HXRSHGIT/Smart-Watch-Rev-1.1/README.md

# Smart Watch Rev 1.1 — HealthOS Band R&D

R&D repository for the client's **HealthOS Band** (WHOOP-style wellness band with a hidden 64×32 OLED).
Source brief: [`docs/HARDWARE_ENGINEER_HANDOFF_REQUIREMENTS.md`](docs/HARDWARE_ENGINEER_HANDOFF_REQUIREMENTS.md) (copied unchanged).

Done by Harsh Thakur.

## Current decision - Iteration 1

**Approved 2026-10-18:** build a USB-powered custom sensor-test PCB using **ESP32-C3-MINI-1-N4 + MAX30102 + MAX30208**. A board larger than the final band is acceptable. Use USB for raw-data logging and test BLE; the module's 4 MB flash is sufficient for firmware/settings and limited logs, so **no external flash is fitted**.

The authoritative scope, selected parts, power/interface circuits, deferred features and bring-up gates are in **[Iteration 1 decision](docs/ITERATION_1_DECISION.md)**. Temperature sensing is included; battery charging, display, haptics, motion/pressure sensors and NFC are deferred. This freezes the iteration's direction, not a fabrication-ready or sourcing-verified BOM.

For the next engineering stage, see **[Iteration 1 schematic connection plan](docs/ITERATION_1_SCHEMATIC_FLOW.md)**: power and signal flow, proposed GPIO map, sensor interfaces, USB/boot/debug wiring and the checks required before schematic/layout release.

The client-facing **[Component Selection](docs/COMPONENT_SELECTION.md)** explains every selected part, its purpose, implementation considerations and the features deferred from the first board.

The documents under `research/` describe the earlier full-wearable investigations. Their parts and performance estimates are **not the current Iteration 1 BOM**. The original client brief remains intact as the longer-term product reference.

## How this repo is organised

`main` holds the brief, this index, the R&D map **and all research merged in** (folders below). Each topic also stays on its **own `rnd/*` branch** for a separate view.

| Branch | Folder | Covers (brief §) |
|---|---|---|
| `rnd/components` | [`research/components/`](research/components/) | §8 — every candidate part plus alternatives, full detail (`COMPONENTS.md`) |
| `rnd/mcu-ble` | [`research/mcu-ble/`](research/mcu-ble/) | §4.6, §8 — nRF5340 vs nRF54, BLE security, DFU, antenna |
| `rnd/storage-nfc-dft` | [`research/storage-nfc-dft/`](research/storage-nfc-dft/) | §4.6, §8 — external flash, active NFC, SWD, production test |
| `rnd/power-battery` | [`research/power-battery/`](research/power-battery/) | §4.7, §8 — power tree, battery sizing, battery-life model, pogo charging, peaks |
| `rnd/display-haptics` | [`research/display-haptics/`](research/display-haptics/) | §4.4, §4.5 — OLED module, dead-front, back-power, LRA and driver |
| `rnd/optical-ppg` | [`research/optical-ppg/`](research/optical-ppg/) | §4.1, §8 — PPG HR, SpO2, optical stack, crosstalk |
| `rnd/sensors` | [`research/sensors/`](research/sensors/) | §4.1 — IMU, pressure and vent, skin temperature, time sync |
| `rnd/algorithms` | [`research/algorithms/`](research/algorithms/) | §4.2, §4.3, §5 — activity, calories, sleep, HRV and other P1 algorithms |
| `rnd/validation` | [`research/validation/`](research/validation/) | §13–15 — test plan, compliance, mechanical, RF, water and sweat |

## Earlier wearable R&D findings (historical, not the Iteration 1 baseline)

These findings are retained as research history, including assumptions and claims requiring further verification. In particular, the original PPG pulse limits, PVLED headroom reasoning, BMI270 current, NFC power assumptions and battery estimates must be rechecked before reuse. See the current decision above for what will actually be fitted now.

1. **Battery life is a PPG-settings decision.** Same hardware: ≈ 5 / 10 / 29 mAh per day for lean / typical / continuous-100-sps profiles → 5 days needs ≈ 32 / 61 / 184 mAh. Suggested target: 5 days on ≈ 150 mAh with adaptive PPG (`rnd/power-battery`).
2. **SoC: nRF54L15** (CSP if HDI is available) instead of nRF5340 — saves ≈ 50 mm²; battery difference ≈ 2 µA (`rnd/mcu-ble`).
3. **One 1.8 V digital rail.** MAX86141 is 1.8 V SPI, so swap the 3 V-only W25Q32RV flash for Macronix MX25R3235F (`rnd/storage-nfc-dft`).
4. **PPG LED supply needs ≥ 3.1 V** and cannot come from the nPM1300 bucks — VBAT direct (HR pauses near empty) or a small boost (`rnd/power-battery`, `rnd/optical-ppg`).
5. **Drop the active NFC reader** (no use case, ≈ 400 mA peak); the SoC's passive NFC tag gives tap-to-pair for free (`rnd/storage-nfc-dft`).
6. **BMI270 always-on accel (≈ 210 µA, verify) is a top load**, and it cannot do wrist-raise and tap at the same time — consider a low-power wake accelerometer (`rnd/sensors`, `rnd/display-haptics`).
7. **Stealth dead-front is not readable in direct sun**; an AR coating is the biggest improvement (`rnd/display-haptics`).
8. **SpO2 skin-tone bias is documented** — validate per Monk skin-tone group + ITA following FDA's 2025 draft study design (`rnd/optical-ppg`).
9. **Calories are the weakest output industry-wide** (27–93 % median error in published tests) — label as estimates (`rnd/algorithms`).
10. **§13 gates → 25 concrete tests**; wellness position depends on claims; water target at least IPX7 (`rnd/validation`).

## Longer-term wearable R&D map

Legend: **R&D** = open question, needs study or experiment · **Design** = known engineering, needs careful execution · **Owner** = client decision, not engineering.

| § | Point | Class | Why |
|---|---|---|---|
| 2 | Stealth dead-front vs visible OLED, same PCB | **R&D** | Transmission vs off-state blackness trade; needs material samples and measurement |
| 3 | Present all health outputs as estimates | Owner | Wording and claims policy; the sentence is cut off in the brief |
| 4.1 | Continuous / resting HR | **R&D** | Wrist PPG motion artifact; LED current vs battery |
| 4.1 | Workout HR and zones | **R&D** | HR accuracy during motion is the hardest PPG problem |
| 4.1 | Spot + sleep SpO2 | **R&D** | Reflective wrist SpO2 needs red/IR calibration against a reference; skin-tone bias |
| 4.1 | Skin temperature trend | **R&D** | Thermal isolation from PCB and battery heat; trend vs absolute |
| 4.1 | Motion data | Design | BMI270 is mature; orientation and FIFO setup |
| 4.1 | Pressure for floors | **R&D** | Waterproof breathable vent; sensitivity to wrist movement and temperature |
| 4.1 | Raw data access | Design | Logging and streaming bandwidth over BLE and flash |
| 4.1 | Sensor time sync | **R&D** | Common timebase across AFE, IMU and MCU FIFOs |
| 4.2 | Steps / distance / active min | Design | Known algorithms; tuning for wrist placement |
| 4.2 | Calories | **R&D** | Model choice (HR + motion + profile); estimate only |
| 4.2 | Floors / elevation | **R&D** | Barometer + IMU fusion |
| 4.2 | Activity classification + confidence | **R&D** | Needs a labelled dataset and an on-device model budget |
| 4.3 | Sleep detection / duration | **R&D** | Actigraphy + HR; validation vs reference |
| 4.3 | HW readiness for HRV / RR / stages | **R&D** | Sets PPG sample rate and timing jitter requirements now |
| 4.4 | 64×32 OLED module choice | **R&D** | Exact orderable module, flex, cover stack, outdoor readability |
| 4.4 | No back-power when display off | Design | Load switch + I/O state; measure leakage |
| 4.4 | Wake by gesture / tap | **R&D** | False-wake rate vs IMU power |
| 4.5 | LRA selection + patterns | **R&D** | Size, resonance, peak current, mounting in a thin band |
| 4.6 | BLE Android/iOS | Owner | Platforms to support |
| 4.6 | Secure pairing + authenticated DFU | Design | MCUboot / nRF Connect SDK; key management |
| 4.6 | External flash logging | Design | Capacity sizing vs offline days |
| 4.6 | SWD + production test access | Design | Pad plan, fixture |
| 4.7 | Battery capacity vs 5–7 days | **R&D** | Needs a duty-cycle power model, then a cell that fits the enclosure |
| 4.7 | Reversible pogo, faults | **R&D** | Bridge vs ideal-diode orientation fix, contact heating, ESD |
| 4.7 | Concurrent peak load | **R&D** | PPG pulses + radio + flash + haptic + NFC on a small cell |
| 4.7 | Charging limits | Design | Follow the cell datasheet; NTC wiring to nPM1300 |
| 5 | P1: HRV, RR, recovery, GPS, falls | **R&D** | Algorithm work; HW must not block it |
| 8 | MCU choice (nRF5340 vs nRF54) | **R&D** | Trade study before schematic freeze |
| 8 | Active NFC (ST25R210) | **R&D** | Use case unknown; power and antenna cost |
| 8 | Separate optical / NFC / display rails | **R&D** | Depends on the power model |
| 13 | Acceptance gates | Design | Test plan and fixtures per gate |

## Gaps in the brief

- Sections **6, 7, 9, 10, 11 and 12 are missing** (numbering jumps 5 → 8 → 13). Probably owner decisions, targets and deliverables. Ask the client.
- §3 is cut off mid-sentence: "…must be presented as estimates until the complete product".
- Open owner decisions: phone platforms, battery-life target, NFC use case, display module, water-resistance target.
