HXRSHGIT/Smart-Watch-Rev-1.1/hardware/schematic/BOM.csv

Reference | Value | Footprint | Spec | MPN | Source | Note
AE1 | 2450AT18A0100001E | smartwatch:Johanson_2450AT18A0100001E_1206 |  |  | Johanson DS 36S0021A rev 4.0
C1 | 2.2uF | Capacitor_SMD:C_0201_0603Metric | X6T 20% 2.5V |  | nRF54L15 DS v1.0 Table 87 / Fig 180
C2 | 2.2uF | Capacitor_SMD:C_0201_0603Metric | X6T 20% 2.5V |  | nRF54L15 DS v1.0 Table 87 / Fig 180
C3 | 10uF | Capacitor_SMD:C_0402_1005Metric | X6S 20% 6.3V |  | nRF54L15 DS v1.0 Table 87 / Fig 180
C4 | 100nF | Capacitor_SMD:C_0201_0603Metric | X7R 10% |  | nRF54L15 DS v1.0 Table 87 / Fig 180
C5 | 2.2nF | Capacitor_SMD:C_0201_0603Metric | X7R 10% 10V |  | nRF54L15 DS v1.0 Table 87 / Fig 180
C6 | 1.5pF | Capacitor_SMD:C_0201_0603Metric | NP0 0.05 pF 25V high Q | GJM0335C1E1R5WB01 | nRF54L15 DS v1.0 Fig 180 / Table 87
C7 | 100nF | Capacitor_SMD:C_0201_0603Metric | X7R 10% |  | nRF54L15 DS v1.0 Table 87 / Fig 180
C8 | 100nF | Capacitor_SMD:C_0201_0603Metric | X7R 10% |  | nRF54L15 DS v1.0 Table 87 / Fig 180
C9 | 2.0pF | Capacitor_SMD:C_0201_0603Metric | NP0 0.05 pF 25V | GJM0335C1E2R0WB01 | nRF54L15 DS v1.0 Fig 180 / Table 87
C10 | 100nF | Capacitor_SMD:C_0201_0603Metric | X7R 10% |  | nRF54L15 DS v1.0 Table 87 / Fig 180
C11 | 0.3pF | Capacitor_SMD:C_0201_0603Metric | C0G 0.1 pF 50V |  | nRF54L15 DS v1.0 Fig 180 / Table 87
C12 | 10nF | Capacitor_SMD:C_0201_0603Metric | X7R 6.3V |  | nRF54L15 DS v1.0 Table 87 / Fig 180
C13 | 3.9pF | Capacitor_SMD:C_0201_0603Metric | C0G 0.25pF 50V |  | nRF54L15 DS v1.0 Table 87 / Fig 180
C14 | TBD | Capacitor_SMD:C_0402_1005Metric | shunt slot, tune on worn band |  | Johanson DS 36S0021A note 4 | DNP
C15 | 22uF | Capacitor_SMD:C_0402_1005Metric | 6.3V or higher, effective ~10 uF |  | MAX86141 DS Rev 5 p.49
C16 | 100nF | Capacitor_SMD:C_0201_0603Metric | at the VDD_ANA ball |  | MAX86141 DS Rev 5 p.12
C17 | 1uF | Capacitor_SMD:C_0201_0603Metric | 6.3V (VREF is 1.21 V) |  | MAX86141 DS Rev 5 p.12
C18 | 10uF | Capacitor_SMD:C_0603_1608Metric | 10V X5R (VLED up to 5.5 V) |  | MAX86141 DS Rev 5 p.12
C19 | 100nF | Capacitor_SMD:C_0201_0603Metric | X7R 10% |  | BMI270 DS Rev 08 section 7.2
C20 | 100nF | Capacitor_SMD:C_0201_0603Metric | X7R 10% |  | BMI270 DS Rev 08 section 7.2
C21 | 100nF | Capacitor_SMD:C_0201_0603Metric | X7R 10% |  | MAX30208 DS Rev 1 p.5 pin table
C22 | 2.2uF | Capacitor_SMD:C_0402_1005Metric | X5R 6.3V min |  | TPS61240 DS SLVS806D Table 2
C23 | 10uF | Capacitor_SMD:C_0603_1608Metric | X5R 10V (effective >= 2.7 uF at 5 V) |  | TPS61240 DS SLVS806D 10.2.2.4
C24 | 10uF | Capacitor_SMD:C_0603_1608Metric | 10V low ESR, >= 10 uF |  | OCVPB21-13F6 DS13107 Rev 3 Table 2
C25 | 1uF | Capacitor_SMD:C_0603_1608Metric | X5R 10V 10% |  | nPM1300 PS v1.3 Reference circuitry, Configuration 2 C1
C26 | 1uF | Capacitor_SMD:C_0603_1608Metric | X5R 10V 10%, mandatory on VBUSOUT |  | nPM1300 PS v1.3 Reference circuitry, Configuration 2 C5
C27 | 10uF | Capacitor_SMD:C_0603_1608Metric | X5R 25V 20%, returns to PVSS1 |  | nPM1300 PS v1.3 Reference circuitry, Configuration 2 C2
C28 | 10uF | Capacitor_SMD:C_0603_1608Metric | X5R 25V 20% |  | nPM1300 PS v1.3 Reference circuitry, Configuration 2 C4
C29 | 10uF | Capacitor_SMD:C_0603_1608Metric | X5R 25V 20% (>= 4 uF effective) |  | nPM1300 PS v1.3 Reference circuitry, Configuration 2 C7
C30 | 2.2uF | Capacitor_SMD:C_0603_1608Metric | X7R 16V 10% |  | nPM1300 PS v1.3 Reference circuitry, Configuration 2 C6
C31 | 100nF | Capacitor_SMD:C_0201_0603Metric | X5R 10% |  | nPM1300 PS v1.3 Reference circuitry, Configuration 2 C13
C32 | 100nF | Capacitor_SMD:C_0201_0603Metric | X7R 10%, close to the VCC land |  | MX25R3235F DS rev 1.6 section 12
D1 | SFH 7016 | smartwatch:SFH7016_1.85x1.65mm
FB1 | 120R@100MHz | Inductor_SMD:L_0201_0603Metric | 200 mA 500 mOhm max |  | nRF54L15 DS v1.0 Table 87 / Fig 180
J1 | Pogo pad | smartwatch:Pogo_Pad_D2.6mm |  |  | research/power-battery/POGO_CHARGING.md
J2 | Pogo pad | smartwatch:Pogo_Pad_D2.6mm |  |  | research/power-battery/POGO_CHARGING.md
J3 | TC2030-NL | Connector:Tag-Connect_TC2030-IDC-NL_2x03_P1.27mm_Vertical
J4 | Battery | Connector_JST:JST_SH_SM03B-SRSS-TB_1x03-1MP_P1.00mm_Horizontal |  |  | battery cell and connector: open item
L1 | 4.7uH | Inductor_SMD:L_0603_1608Metric | 120 mA 20% 650 mOhm |  | nRF54L15 DS v1.0 Table 87 / Fig 180
L2 | 2.7nH | Inductor_SMD:L_0201_0603Metric | 0.1 nH 600 mA | LQP03HQ2N7B02 | nRF54L15 DS v1.0 Fig 180 / Table 87
L3 | 3.5nH | Inductor_SMD:L_0201_0603Metric | 0.1 nH 500 mA | LQP03HQ3N5B02 | nRF54L15 DS v1.0 Fig 180 / Table 87
L4 | 3.5nH | Inductor_SMD:L_0201_0603Metric | 0.1 nH 500 mA | LQP03HQ3N5B02 | nRF54L15 DS v1.0 Fig 180 / Table 87
L5 | 1.0uH | Inductor_SMD:L_0805_2012Metric | 1.0 uH min, Isat > 0.9 A | LQM21PN1R0MC0 | TPS61240 DS SLVS806D Table 2/3
L6 | 2.2uH | Inductor_SMD:L_0805_2012Metric | DCR <= 400 mOhm, Isat > 350 mA, 20% |  | nPM1300 PS v1.3 BUCK component selection
NT1 | NetTie | NetTie:NetTie-2_SMD_Pad0.5mm |  |  | nRF54L15 DS v1.0 Table 87 / Fig 180 note on C6
NT2 | NetTie | NetTie:NetTie-2_SMD_Pad0.5mm |  |  | nRF54L15 DS v1.0 Fig 180 / Table 87 note on C9
NT3 | NetTie | NetTie:NetTie-2_SMD_Pad0.5mm |  |  | MAX86141 DS Rev 5 layout guidelines p.49: PD_GND to ground at one point
NT4 | NetTie | NetTie:NetTie-2_SMD_Pad0.5mm |  |  | nPM1300 PS v1.3 Reference circuitry, Configuration 2 (net tie on PVSS1)
PD1 | VEMD8080 | smartwatch:VEMD8080_4.8x2.5mm
PD2 | VEMD8080 | smartwatch:VEMD8080_4.8x2.5mm
R1 | 1k | Resistor_SMD:R_0201_0603Metric | 1% 0.05W |  | nRF54L15 DS v1.0 Table 87 / Fig 180
R2 | 0R | Resistor_SMD:R_0402_1005Metric | series slot |  | Johanson DS 36S0021A note 4
R3 | 0R | Resistor_SMD:R_0402_1005Metric | series slot |  | Johanson DS 36S0021A note 4
R4 | 100k | Resistor_SMD:R_0201_0603Metric | pull-up |  | MAXREFDES103 R12
R5 | 100k | Resistor_SMD:R_0201_0603Metric | pull-up |  | MAXREFDES103 R23
R6 | 0R | Resistor_SMD:R_0201_0603Metric | link |  | bring-up current measurement
R7 | 0R | Resistor_SMD:R_0201_0603Metric | link |  | bring-up current measurement
R8 | 0R | Resistor_SMD:R_0201_0603Metric | link |  | bring-up current measurement
R9 | 4.7k | Resistor_SMD:R_0201_0603Metric | pull-up |  | I2C 400 kHz, 50 pF -> rise time about 0.2 us
R10 | 4.7k | Resistor_SMD:R_0201_0603Metric | pull-up |  | I2C 400 kHz, 50 pF -> rise time about 0.2 us
R11 | 100k | Resistor_SMD:R_0201_0603Metric | pull-down |  | nRF54L15 errata 103
R12 | 0R | Resistor_SMD:R_0402_1005Metric | VLED from the boost (default, fitted) |  | power tree option B
R13 | 0R | Resistor_SMD:R_0402_1005Metric | VLED straight from VSYS (DNP, power tree option A) |  | power tree option A | DNP
R14 | 180R | Resistor_SMD:R_0402_1005Metric | 1% or better, 51-270 Ohm allowed |  | OCVPB21-13F6 DS13107 Rev 3 section 1.2
R15 | 100k | Resistor_SMD:R_0201_0603Metric | FLAG pull-up |  | OCVPB21-13F6 DS13107 Rev 3 Table 2
R16 | 47k | Resistor_SMD:R_0201_0603Metric | 1% (sets BUCK1 = 1.8 V) |  | nPM1300 PS v1.3 BUCK output voltage selection
R17 | 10k | Resistor_SMD:R_0201_0603Metric | NTC substitute, fit only for a pack WITHOUT thermistor |  | nPM1300 PS v1.3 NTC thermistor configuration
R18 | 100k | Resistor_SMD:R_0201_0603Metric | CS# pull-up |  | MX25R3235F DS rev 1.6 power-on state; nRF54L15 errata 103
SW1 | Ship mode / reset | Button_Switch_SMD:SW_SPST_B3U-1000P |  |  | nPM1300 PS v1.3 Ship and Hibernate modes
TP1 | TP +1V8 | TestPoint:TestPoint_Pad_D1.0mm
TP2 | TP VSYS | TestPoint:TestPoint_Pad_D1.0mm
TP3 | TP VLED | TestPoint:TestPoint_Pad_D1.0mm
TP4 | TP GND | TestPoint:TestPoint_Pad_D1.0mm
TP5 | TP GND | TestPoint:TestPoint_Pad_D1.0mm
TP6 | TP I2C_SDA | TestPoint:TestPoint_Pad_D1.0mm
TP7 | TP I2C_SCL | TestPoint:TestPoint_Pad_D1.0mm
TP8 | TP SPI_SCK | TestPoint:TestPoint_Pad_D1.0mm
TP9 | TP SPI_MOSI | TestPoint:TestPoint_Pad_D1.0mm
TP10 | TP SPI_MISO | TestPoint:TestPoint_Pad_D1.0mm
TP11 | TP PPG_INT | TestPoint:TestPoint_Pad_D1.0mm
U1 | nRF54L15-QFAA | Package_DFN_QFN:QFN-48-1EP_6x6mm_P0.4mm_EP4.6x4.6mm
U2 | MAX86141ENP+ | smartwatch:MAX86141_WLP-20_2.048x1.848mm_P0.4mm
U3 | BMI270 | Package_LGA:Bosch_LGA-14_3x2.5mm_P0.5mm
U4 | MAX30208 | smartwatch:MAX30208_TLGA-10_2x2mm
U5 | TPS61240DRVR | Package_SON:WSON-6-1EP_2x2mm_P0.65mm_EP1x1.6mm
U6 | OCVPB21-13F6 | smartwatch:OCVPB21-13F6_WLCSP-13_P0.4mm
U7 | nPM1300-QEAA | Package_DFN_QFN:QFN-32-1EP_5x5mm_P0.5mm_EP3.45x3.45mm
U8 | MX25R3235FZBIL0 | smartwatch:MX25R3235F_USON-8_4x3mm_P0.8mm
X1 | 32.768kHz | Crystal:Crystal_SMD_2012-2Pin_2.0x1.2mm | 2.0x1.2 mm, CL 9 pF, total tol 20 ppm |  | nRF54L15 DS v1.0 Table 87 / Fig 180
X2 | 32MHz | Crystal:Crystal_SMD_2016-4Pin_2.0x1.6mm | 2.0x1.6 mm, CL 8 pF, total tol 40 ppm |  | nRF54L15 DS v1.0 Table 87 / Fig 180
