HXRSHGIT/Smart-Watch-Rev-1.1/hardware/schematic/input_protection.kicad_sch

## KiCad design hardware/schematic/input_protection.kicad_sch (2026-11-05)

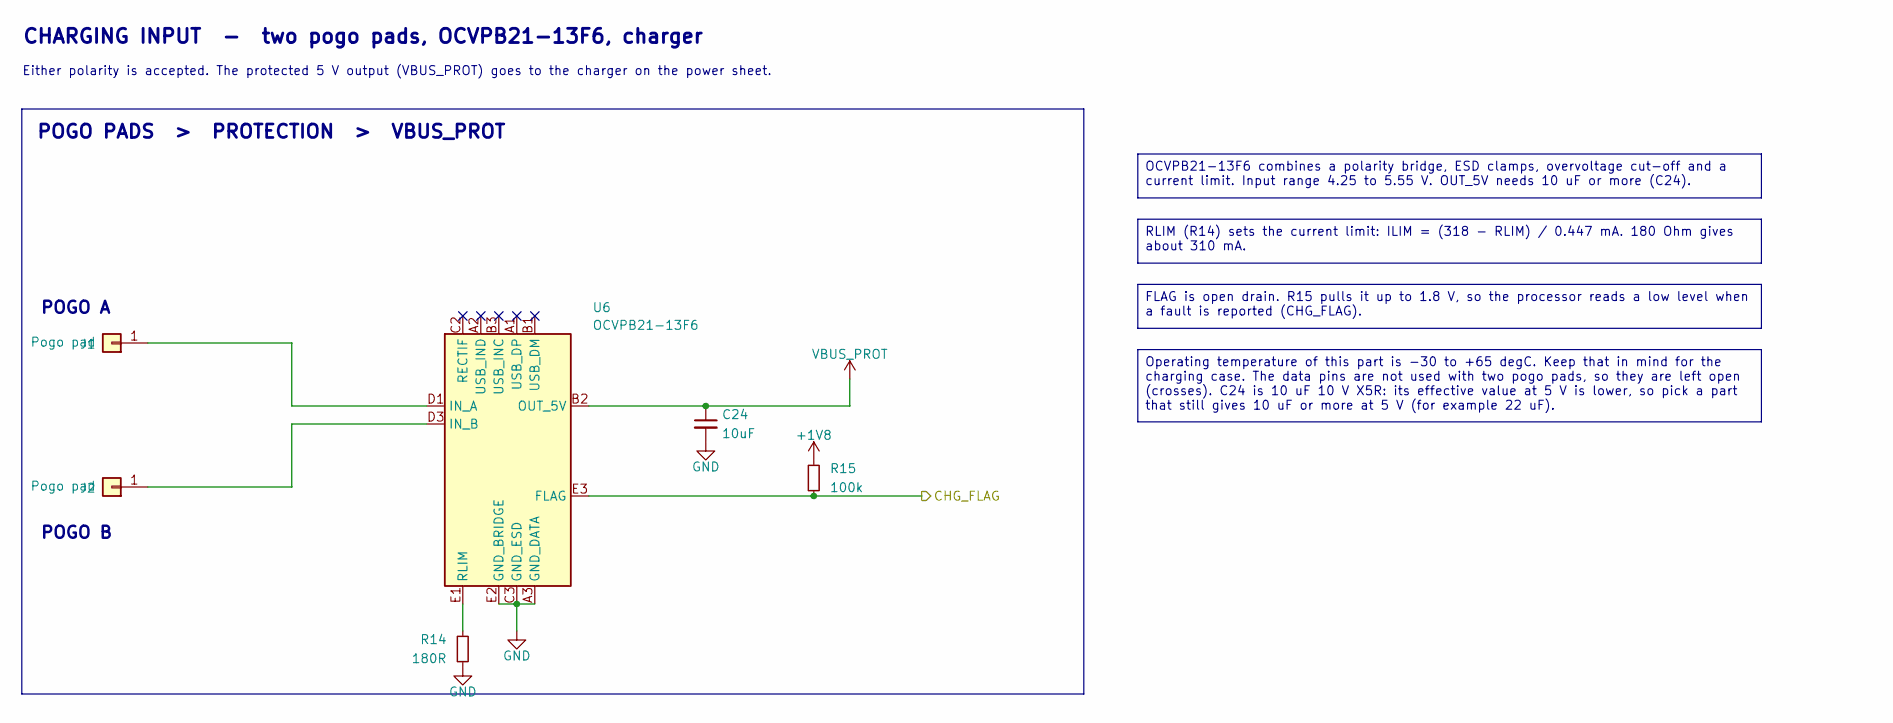
[picture p1: schematic input_protection.kicad_sch]

Parts:
C24: 10uF; C_0603_1608Metric
J1, J2: Pogo pad; Pogo_Pad_D2.6mm
R14: 180R; R_0402_1005Metric
R15: 100k; R_0201_0603Metric
U6: OCVPB21-13F6; OCVPB21-13F6_WLCSP-13_P0.4mm

Connections:
+1V8: R15.1
CHG_FLAG: R15.2, U6.E3 (FLAG)
GND: C24.2, R14.2, U6.A3 (GND_DATA), U6.C3 (GND_ESD), U6.E2 (GND_BRIDGE)
unnamed: J1.1, U6.D1 (IN_A)
unnamed: J2.1, U6.D3 (IN_B)
unnamed: R14.1, U6.E1 (RLIM)
VBUS_PROT: C24.1, U6.B2 (OUT_5V)

Notes on the sheet:
CHARGING INPUT - two pogo pads, OCVPB21-13F6, charger
Either polarity is accepted. The protected 5 V output (VBUS_PROT) goes to the charger on the power sheet.
POGO PADS > PROTECTION > VBUS_PROT
POGO A
POGO B
OCVPB21-13F6 combines a polarity bridge, ESD clamps, overvoltage cut-off and a current limit. Input range 4.25 to 5.55 V. OUT_5V needs 10 uF or more (C24).
RLIM (R14) sets the current limit: ILIM = (318 - RLIM) / 0.447 mA. 180 Ohm gives about 310 mA.
FLAG is open drain. R15 pulls it up to 1.8 V, so the processor reads a low level when a fault is reported (CHG_FLAG).
Operating temperature of this part is -30 to +65 degC. Keep that in mind for the charging case. The data pins are not used with two pogo pads, so they are left open (crosses). C24 is 10 uF 10 V X5R: its effective value at 5 V is lower, so pick a part that still gives 10 uF or more at 5 V (for examp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
