HXRSHGIT/Smart-Watch-Rev-1.1/hardware/schematic/led_supply.kicad_sch

## KiCad design hardware/schematic/led_supply.kicad_sch (2026-11-05)

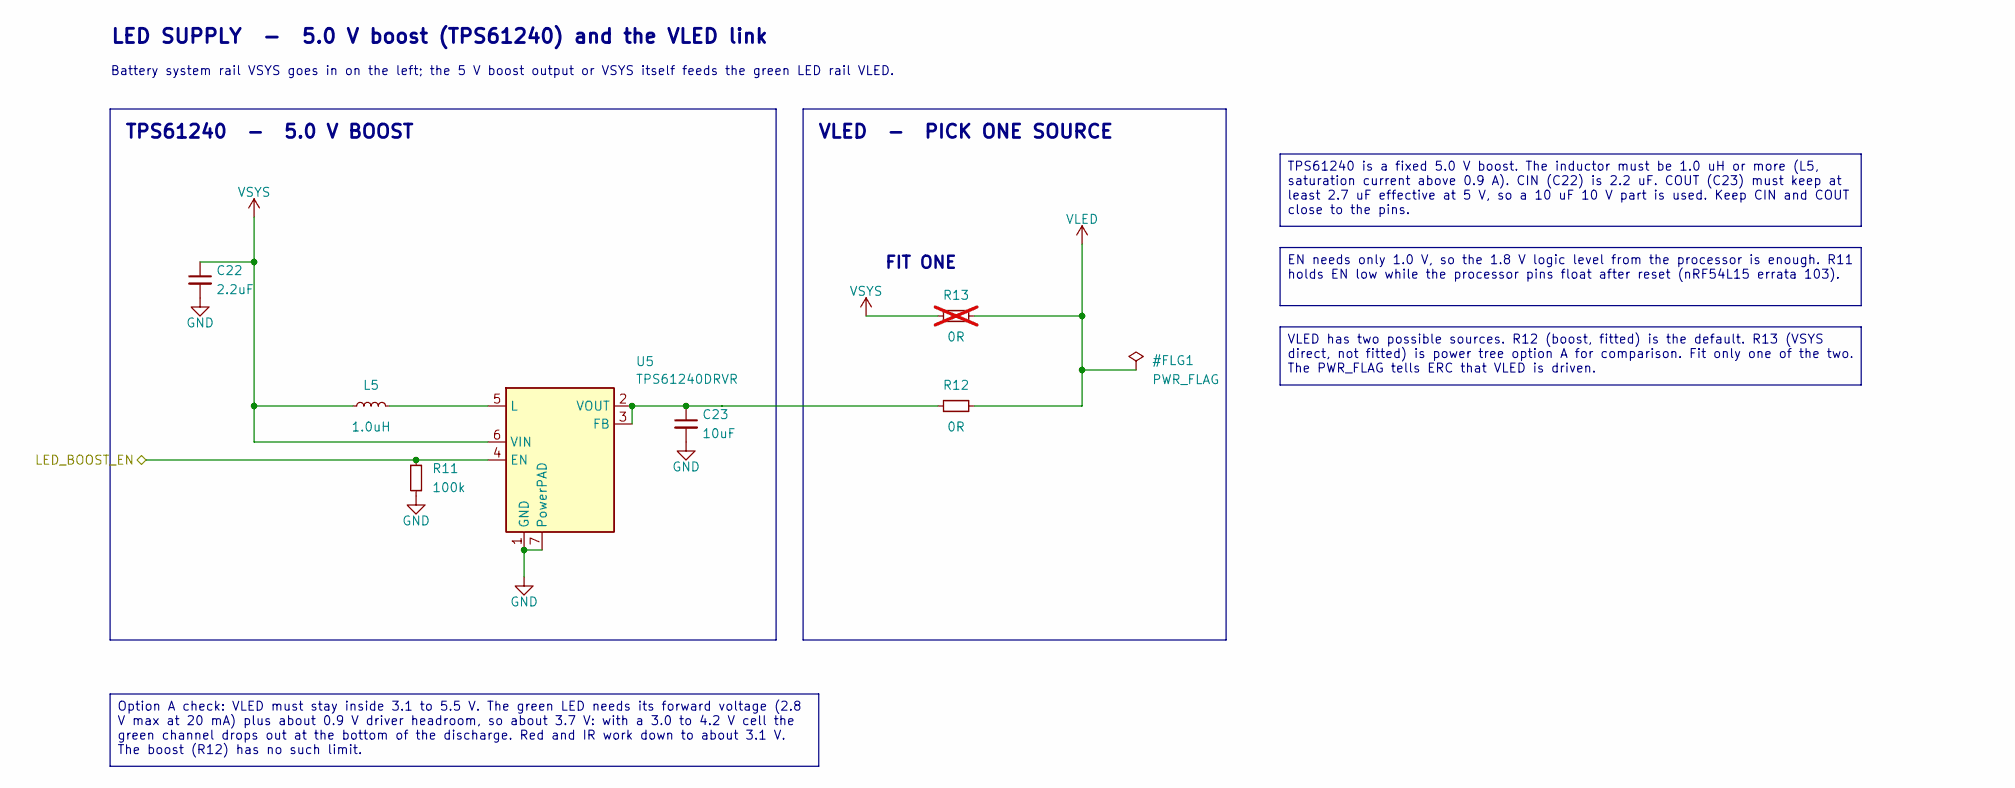
[picture p2: schematic led_supply.kicad_sch]

Parts:
C22: 2.2uF; C_0402_1005Metric
C23: 10uF; C_0603_1608Metric
L5: 1.0uH; L_0805_2012Metric; MPN LQM21PN1R0MC0
R11: 100k; R_0201_0603Metric
R12: 0R; R_0402_1005Metric
R13: 0R; R_0402_1005Metric; not fitted
U5: TPS61240DRVR; WSON-6-1EP_2x2mm_P0.65mm_EP1x1.6mm

Connections:
GND: C22.2, C23.2, R11.2, U5.1 (GND), U5.7 (PowerPAD)
LED_BOOST_EN: R11.1, U5.4 (EN)
unnamed: C23.1, R12.1, U5.2 (VOUT), U5.3 (FB)
unnamed: L5.2, U5.5 (L)
VLED: R12.2, R13.2
VSYS: C22.1, L5.1, R13.1, U5.6 (VIN)

Notes on the sheet:
LED SUPPLY - 5.0 V boost (TPS61240) and the VLED link
Battery system rail VSYS goes in on the left; the 5 V boost output or VSYS itself feeds the green LED rail VLED.
TPS61240 - 5.0 V BOOST
VLED - PICK ONE SOURCE
FIT ONE
TPS61240 is a fixed 5.0 V boost. The inductor must be 1.0 uH or more (L5, saturation current above 0.9 A). CIN (C22) is 2.2 uF. COUT (C23) must keep at least 2.7 uF effective at 5 V, so a 10 uF 10 V part is used. Keep CIN and COUT close to the pins.
EN needs only 1.0 V, so the 1.8 V logic level from the processor is enough. R11 holds EN low while the processor pins float after reset (nRF54L15 errata 103).
VLED has two possible sources. R12 (boost, fitted) is the default. R13 (VSYS direct, not fitted) is power tree option A for comparison. Fit only one of the two. The PWR_FLAG tells ERC that VLED is driven.
Option A check: VLED must stay inside 3.1 to 5.5 V. The green LED needs its forward voltage (2.8 V max at 20 mA) plus about 0.9 V driver headroom, so about 3.7 V: with a 3.0 to 4.2 V cell the green channel drops out at the bottom of the discharge. Red and IR work down to about 3.1 V. The boost (R12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
