HXRSHGIT/Smart-Watch-Rev-1.1/hardware/schematic/mcu.kicad_sch

## KiCad design hardware/schematic/mcu.kicad_sch (2026-11-05)

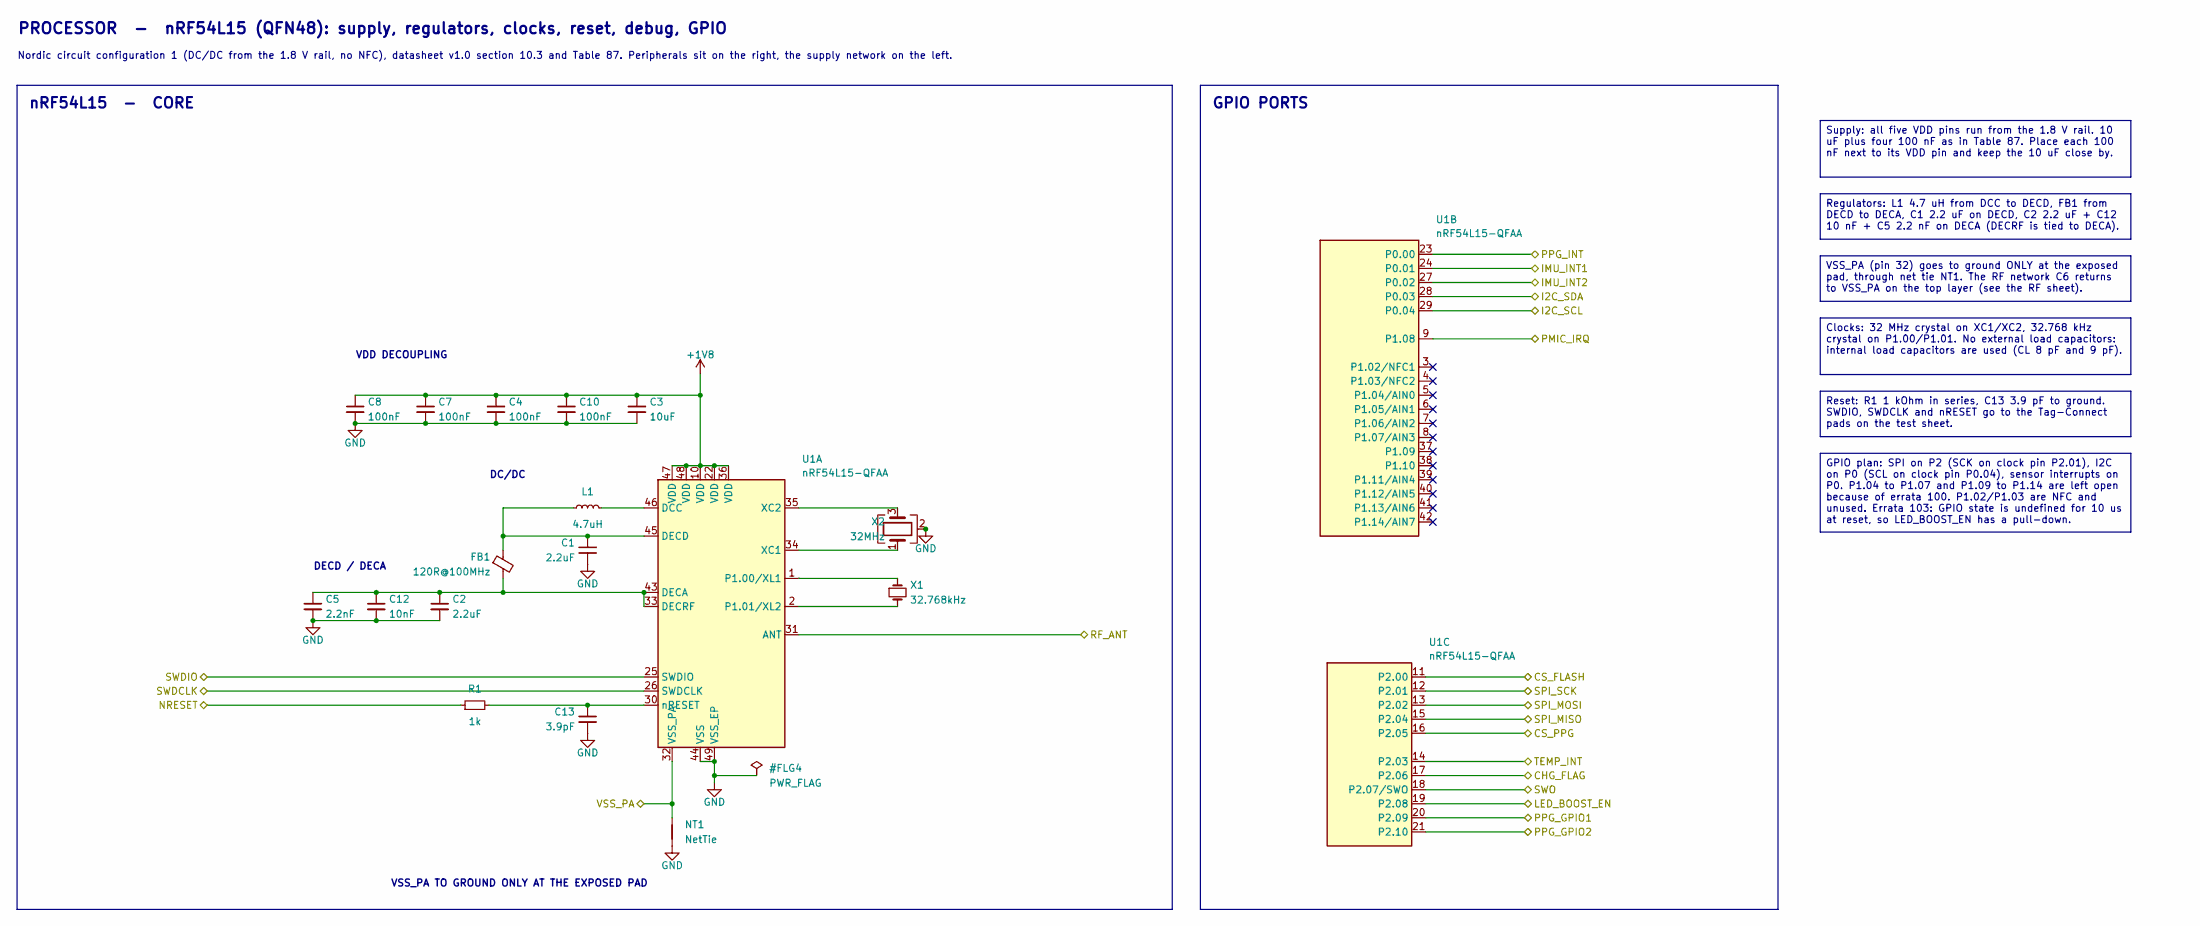
[picture p3: schematic mcu.kicad_sch]

Parts:
C1, C2: 2.2uF; C_0201_0603Metric
C3: 10uF; C_0402_1005Metric
C4, C7, C8, C10: 100nF; C_0201_0603Metric
C5: 2.2nF; C_0201_0603Metric
C12: 10nF; C_0201_0603Metric
C13: 3.9pF; C_0201_0603Metric
FB1: 120R@100MHz; L_0201_0603Metric
L1: 4.7uH; L_0603_1608Metric
NT1: NetTie; NetTie-2_SMD_Pad0.5mm
R1: 1k; R_0201_0603Metric
U1: nRF54L15-QFAA; QFN-48-1EP_6x6mm_P0.4mm_EP4.6x4.6mm
X1: 32.768kHz; Crystal_SMD_2012-2Pin_2.0x1.2mm
X2: 32MHz; Crystal_SMD_2016-4Pin_2.0x1.6mm

Connections:
+1V8: C3.1, C4.1, C7.1, C8.1, C10.1, U1.10 (VDD), U1.22 (VDD), U1.36 (VDD), U1.47 (VDD), U1.48 (VDD)
CHG_FLAG: U1.17 (P2.06)
CS_FLASH: U1.11 (P2.00)
CS_PPG: U1.16 (P2.05)
GND: C1.2, C2.2, C3.2, C4.2, C5.2, C7.2, C8.2, C10.2, C12.2, C13.2, NT1.1, U1.44 (VSS), U1.49 (VSS_EP), X2.2 (G), X2.4 (G)
I2C_SCL: U1.29 (P0.04)
I2C_SDA: U1.28 (P0.03)
IMU_INT1: U1.24 (P0.01)
IMU_INT2: U1.27 (P0.02)
LED_BOOST_EN: U1.19 (P2.08)
NRESET: R1.1
unnamed: C1.1, FB1.1, L1.1, U1.45 (DECD)
unnamed: C2.1, C5.1, C12.1, FB1.2, U1.33 (DECRF), U1.43 (DECA)
unnamed: C13.1, R1.2, U1.30 (nRESET)
unnamed: L1.2, U1.46 (DCC)
unnamed: U1.1 (P1.00/XL1), X1.1
unnamed: U1.2 (P1.01/XL2), X1.2
unnamed: U1.34 (XC1), X2.1
unnamed: U1.35 (XC2), X2.3
PMIC_IRQ: U1.9 (P1.08)
PPG_GPIO1: U1.20 (P2.09)
PPG_GPIO2: U1.21 (P2.10)
PPG_INT: U1.23 (P0.00)
RF_ANT: U1.31 (ANT)
SPI_MISO: U1.15 (P2.04)
SPI_MOSI: U1.13 (P2.02)
SPI_SCK: U1.12 (P2.01)
SWDCLK: U1.26 (SWDCLK)
SWDIO: U1.25 (SWDIO)
SWO: U1.18 (P2.07/SWO)
TEMP_INT: U1.14 (P2.03)
VSS_PA: NT1.2, U1.32 (VSS_PA)

Notes on the sheet:
PROCESSOR - nRF54L15 (QFN48): supply, regulators, clocks, reset, debug, GPIO
Nordic circuit configuration 1 (DC/DC from the 1.8 V rail, no NFC), datasheet v1.0 section 10.3 and Table 87. Peripherals sit on the right, the supply network on the left.
nRF54L15 - CORE
GPIO PORTS
VDD DECOUPLING
DECD / DECA
DC/DC
VSS_PA TO GROUND ONLY AT THE EXPOSED PAD
Supply: all five VDD pins run from the 1.8 V rail. 10 uF plus four 100 nF as in Table 87. Place each 100 nF next to its VDD pin and keep the 10 uF close by.
Regulators: L1 4.7 uH from DCC to DECD, FB1 from DECD to DECA, C1 2.2 uF on DECD, C2 2.2 uF + C12 10 nF + C5 2.2 nF on DECA (DECRF is tied to DECA).
VSS_PA (pin 32) goes to ground ONLY at the exposed pad, through net tie NT1. The RF network C6 returns to VSS_PA on the top layer (see the RF sheet).
Clocks: 32 MHz crystal on XC1/XC2, 32.768 kHz crystal on P1.00/P1.01. No external load capacitors: internal load capacitors are used (CL 8 pF and 9 pF).
Reset: R1 1 kOhm in series, C13 3.9 pF to ground. SWDIO, SWDCLK and nRESET go to the Tag-Connect pads on the test sheet.
GPIO plan: SPI on P2 (SCK on clock pin P2.01), I2C on P0 (SCL on clock pin P0.04), sensor interrupts on P0. P1.04 to P1.07 and P1.09 to P1.14 are left open because of errata 100. P1.02/P1.03 are NFC and unused. Errata 103: GPIO state is undefined for 10 us at reset, so LED_BOOST_EN has a pull-down.
