HXRSHGIT/Smart-Watch-Rev-1.1/hardware/schematic/memory.kicad_sch

## KiCad design hardware/schematic/memory.kicad_sch (2026-11-05)

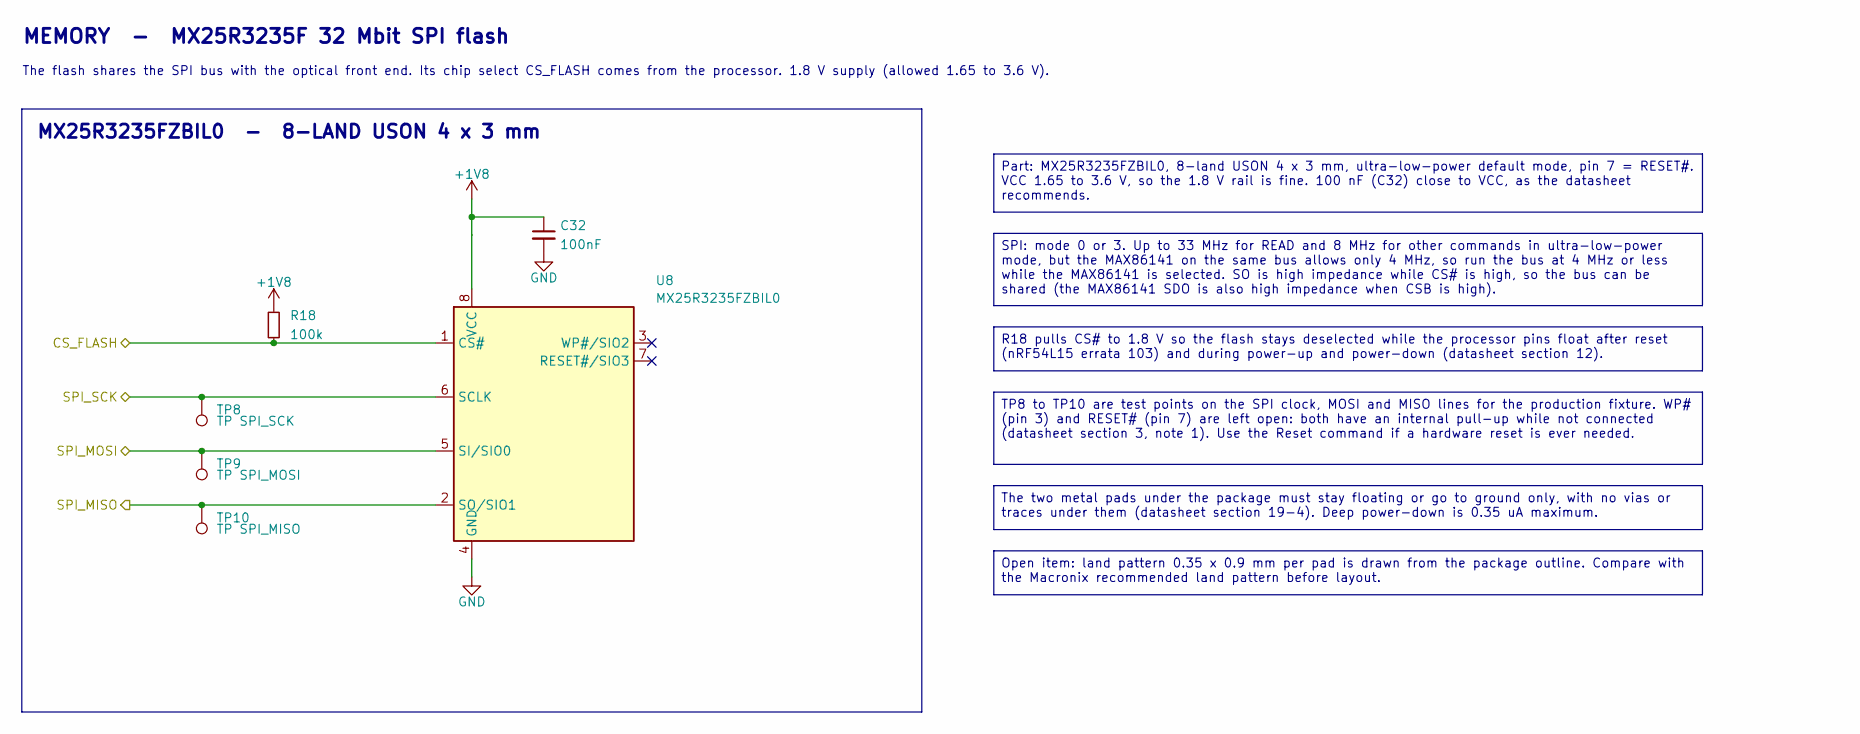
[picture p4: schematic memory.kicad_sch]

Parts:
C32: 100nF; C_0201_0603Metric
R18: 100k; R_0201_0603Metric
TP8: TP SPI_SCK; TestPoint_Pad_D1.0mm
TP9: TP SPI_MOSI; TestPoint_Pad_D1.0mm
TP10: TP SPI_MISO; TestPoint_Pad_D1.0mm
U8: MX25R3235FZBIL0; MX25R3235F_USON-8_4x3mm_P0.8mm

Connections:
+1V8: C32.1, R18.1, U8.8 (VCC)
CS_FLASH: R18.2, U8.1 (CS#)
GND: C32.2, U8.4 (GND)
SPI_MISO: TP10.1, U8.2 (SO/SIO1)
SPI_MOSI: TP9.1, U8.5 (SI/SIO0)
SPI_SCK: TP8.1, U8.6 (SCLK)

Notes on the sheet:
MEMORY - MX25R3235F 32 Mbit SPI flash
The flash shares the SPI bus with the optical front end. Its chip select CS_FLASH comes from the processor. 1.8 V supply (allowed 1.65 to 3.6 V).
MX25R3235FZBIL0 - 8-LAND USON 4 x 3 mm
Part: MX25R3235FZBIL0, 8-land USON 4 x 3 mm, ultra-low-power default mode, pin 7 = RESET#. VCC 1.65 to 3.6 V, so the 1.8 V rail is fine. 100 nF (C32) close to VCC, as the datasheet recommends.
SPI: mode 0 or 3. Up to 33 MHz for READ and 8 MHz for other commands in ultra-low-power mode, but the MAX86141 on the same bus allows only 4 MHz, so run the bus at 4 MHz or less while the MAX86141 is selected. SO is high impedance while CS# is high, so the bus can be shared (the MAX86141 SDO is als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
R18 pulls CS# to 1.8 V so the flash stays deselected while the processor pins float after reset (nRF54L15 errata 103) and during power-up and power-down (datasheet section 12).
TP8 to TP10 are test points on the SPI clock, MOSI and MISO lines for the production fixture. WP# (pin 3) and RESET# (pin 7) are left open: both have an internal pull-up while not connected (datasheet section 3, note 1). Use the Reset command if a hardware reset is ever needed.
The two metal pads under the package must stay floating or go to ground only, with no vias or traces under them (datasheet section 19-4). Deep power-down is 0.35 uA maximum.
Open item: land pattern 0.35 x 0.9 mm per pad is drawn from the package outline. Compare with the Macronix recommended land pattern before layout.
