HXRSHGIT/Smart-Watch-Rev-1.1/hardware/schematic/optical.kicad_sch

## KiCad design hardware/schematic/optical.kicad_sch (2026-11-05)

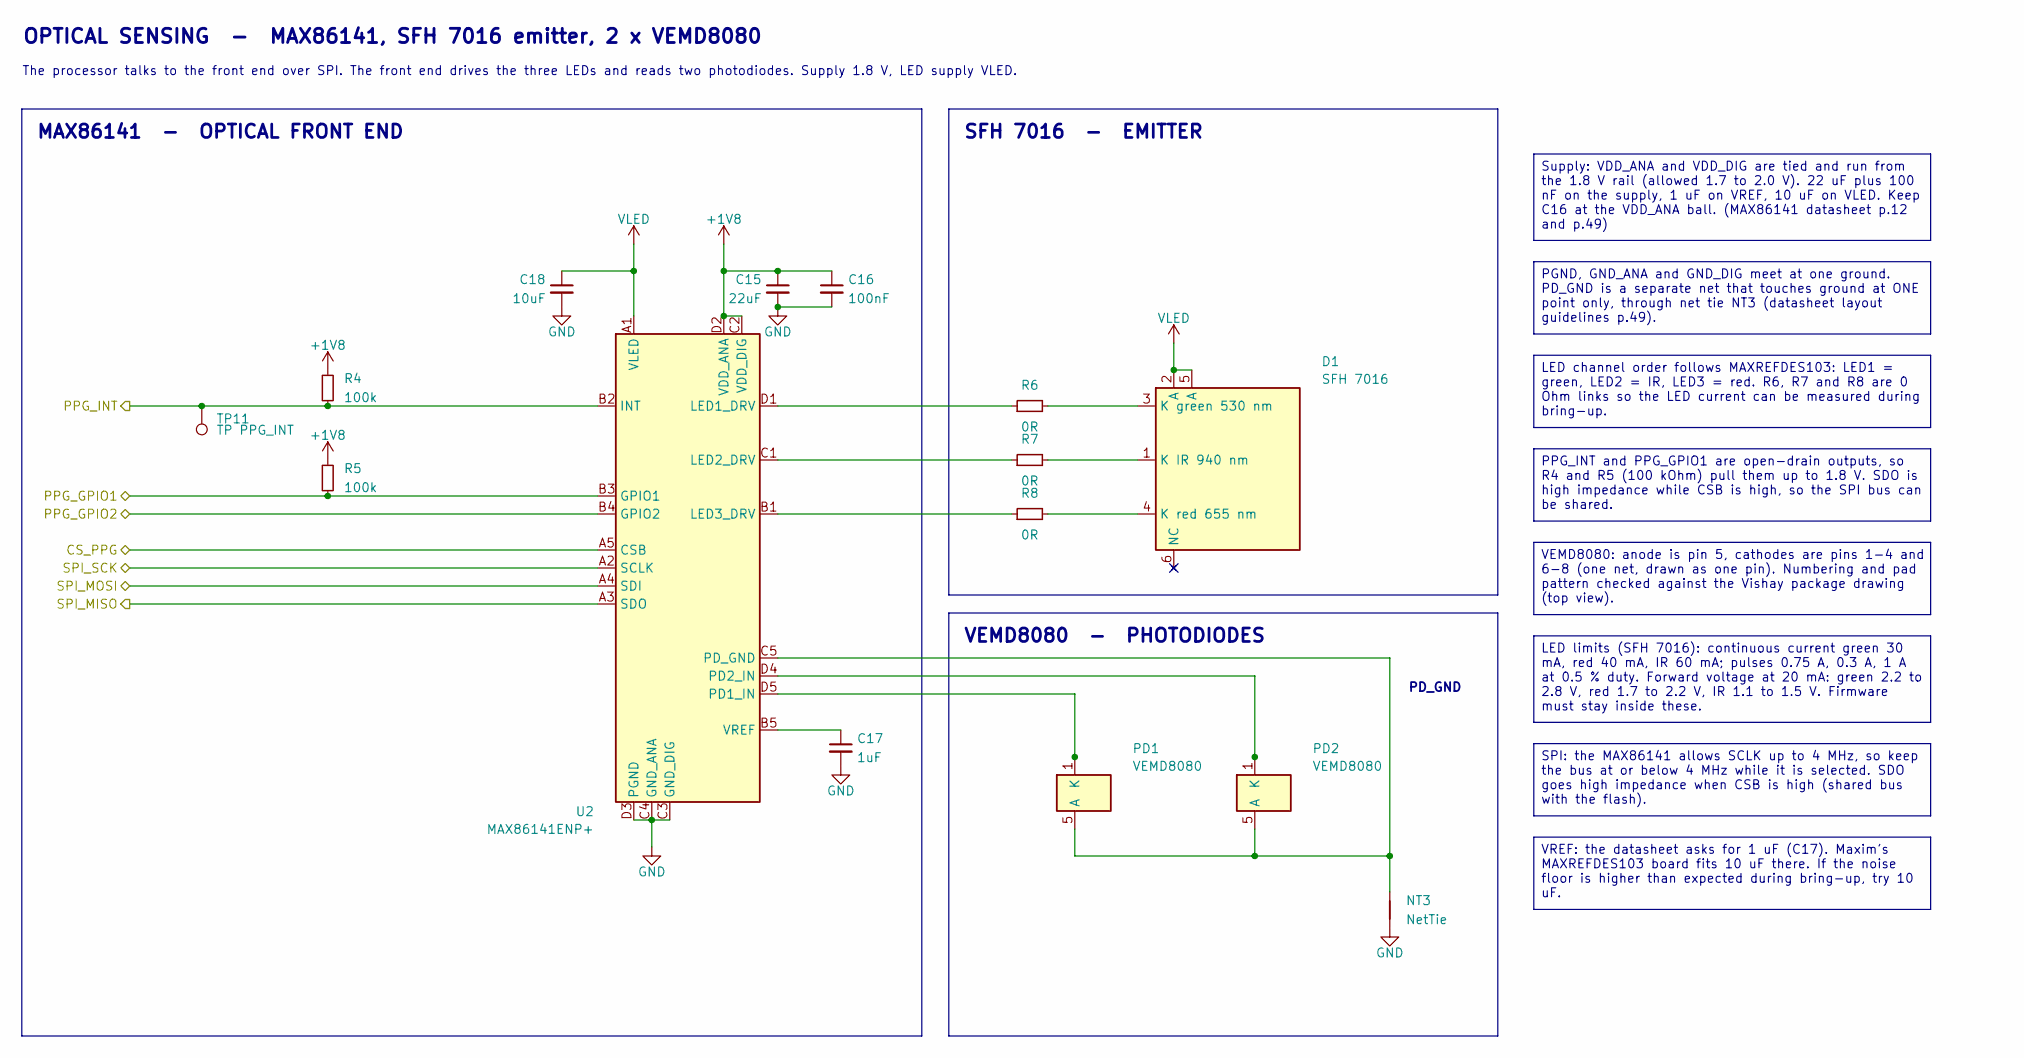
[picture p5: schematic optical.kicad_sch]

Parts:
C15: 22uF; C_0402_1005Metric
C16: 100nF; C_0201_0603Metric
C17: 1uF; C_0201_0603Metric
C18: 10uF; C_0603_1608Metric
D1: SFH 7016; SFH7016_1.85x1.65mm
NT3: NetTie; NetTie-2_SMD_Pad0.5mm
PD1, PD2: VEMD8080; VEMD8080_4.8x2.5mm
R4, R5: 100k; R_0201_0603Metric
R6, R7, R8: 0R; R_0201_0603Metric
TP11: TP PPG_INT; TestPoint_Pad_D1.0mm
U2: MAX86141ENP+; MAX86141_WLP-20_2.048x1.848mm_P0.4mm

Connections:
+1V8: C15.1, C16.1, R4.1, R5.1, U2.C2 (VDD_DIG), U2.D2 (VDD_ANA)
CS_PPG: U2.A5 (CSB)
GND: C15.2, C16.2, C17.2, C18.2, NT3.1, U2.C3 (GND_DIG), U2.C4 (GND_ANA), U2.D3 (PGND)
unnamed: C17.1, U2.B5 (VREF)
unnamed: D1.1 (K IR 940 nm), R7.2
unnamed: D1.3 (K green 530 nm), R6.2
unnamed: D1.4 (K red 655 nm), R8.2
unnamed: NT3.2, PD1.5 (A), PD2.5 (A), U2.C5 (PD_GND)
unnamed: PD1.1 (K), PD1.2 (K), PD1.3 (K), PD1.4 (K), PD1.6 (K), PD1.7 (K), PD1.8 (K), U2.D5 (PD1_IN)
unnamed: PD2.1 (K), PD2.2 (K), PD2.3 (K), PD2.4 (K), PD2.6 (K), PD2.7 (K), PD2.8 (K), U2.D4 (PD2_IN)
unnamed: R6.1, U2.D1 (LED1_DRV)
unnamed: R7.1, U2.C1 (LED2_DRV)
unnamed: R8.1, U2.B1 (LED3_DRV)
PPG_GPIO1: R5.2, U2.B3 (GPIO1)
PPG_GPIO2: U2.B4 (GPIO2)
PPG_INT: R4.2, TP11.1, U2.B2 (INT)
SPI_MISO: U2.A3 (SDO)
SPI_MOSI: U2.A4 (SDI)
SPI_SCK: U2.A2 (SCLK)
VLED: C18.1, D1.2 (A), D1.5 (A), U2.A1 (VLED)

Notes on the sheet:
OPTICAL SENSING - MAX86141, SFH 7016 emitter, 2 x VEMD8080
The processor talks to the front end over SPI. The front end drives the three LEDs and reads two photodiodes. Supply 1.8 V, LED supply VLED.
MAX86141 - OPTICAL FRONT END
SFH 7016 - EMITTER
VEMD8080 - PHOTODIODES
PD_GND
Supply: VDD_ANA and VDD_DIG are tied and run from the 1.8 V rail (allowed 1.7 to 2.0 V). 22 uF plus 100 nF on the supply, 1 uF on VREF, 10 uF on VLED. Keep C16 at the VDD_ANA ball. (MAX86141 datasheet p.12 and p.49)
PGND, GND_ANA and GND_DIG meet at one ground. PD_GND is a separate net that touches ground at ONE point only, through net tie NT3 (datasheet layout guidelines p.49).
LED channel order follows MAXREFDES103: LED1 = green, LED2 = IR, LED3 = red. R6, R7 and R8 are 0 Ohm links so the LED current can be measured during bring-up.
PPG_INT and PPG_GPIO1 are open-drain outputs, so R4 and R5 (100 kOhm) pull them up to 1.8 V. SDO is high impedance while CSB is high, so the SPI bus can be shared.
VEMD8080: anode is pin 5, cathodes are pins 1-4 and 6-8 (one net, drawn as one pin). Numbering and pad pattern checked against the Vishay package drawing (top view).
LED limits (SFH 7016): continuous current green 30 mA, red 40 mA, IR 60 mA; pulses 0.75 A, 0.3 A, 1 A at 0.5 % duty. Forward voltage at 20 mA: green 2.2 to 2.8 V, red 1.7 to 2.2 V, IR 1.1 to 1.5 V. Firmware must stay inside these.
SPI: the MAX86141 allows SCLK up to 4 MHz, so keep the bus at or below 4 MHz while it is selected. SDO goes high impedance when CSB is high (shared bus with the flash).
VREF: the datasheet asks for 1 uF (C17). Maxim's MAXREFDES103 board fits 10 uF there. If the noise floor is higher than expected during bring-up, try 10 uF.
