HXRSHGIT/Smart-Watch-Rev-1.1/hardware/schematic/power.kicad_sch

## KiCad design hardware/schematic/power.kicad_sch (2026-11-05)

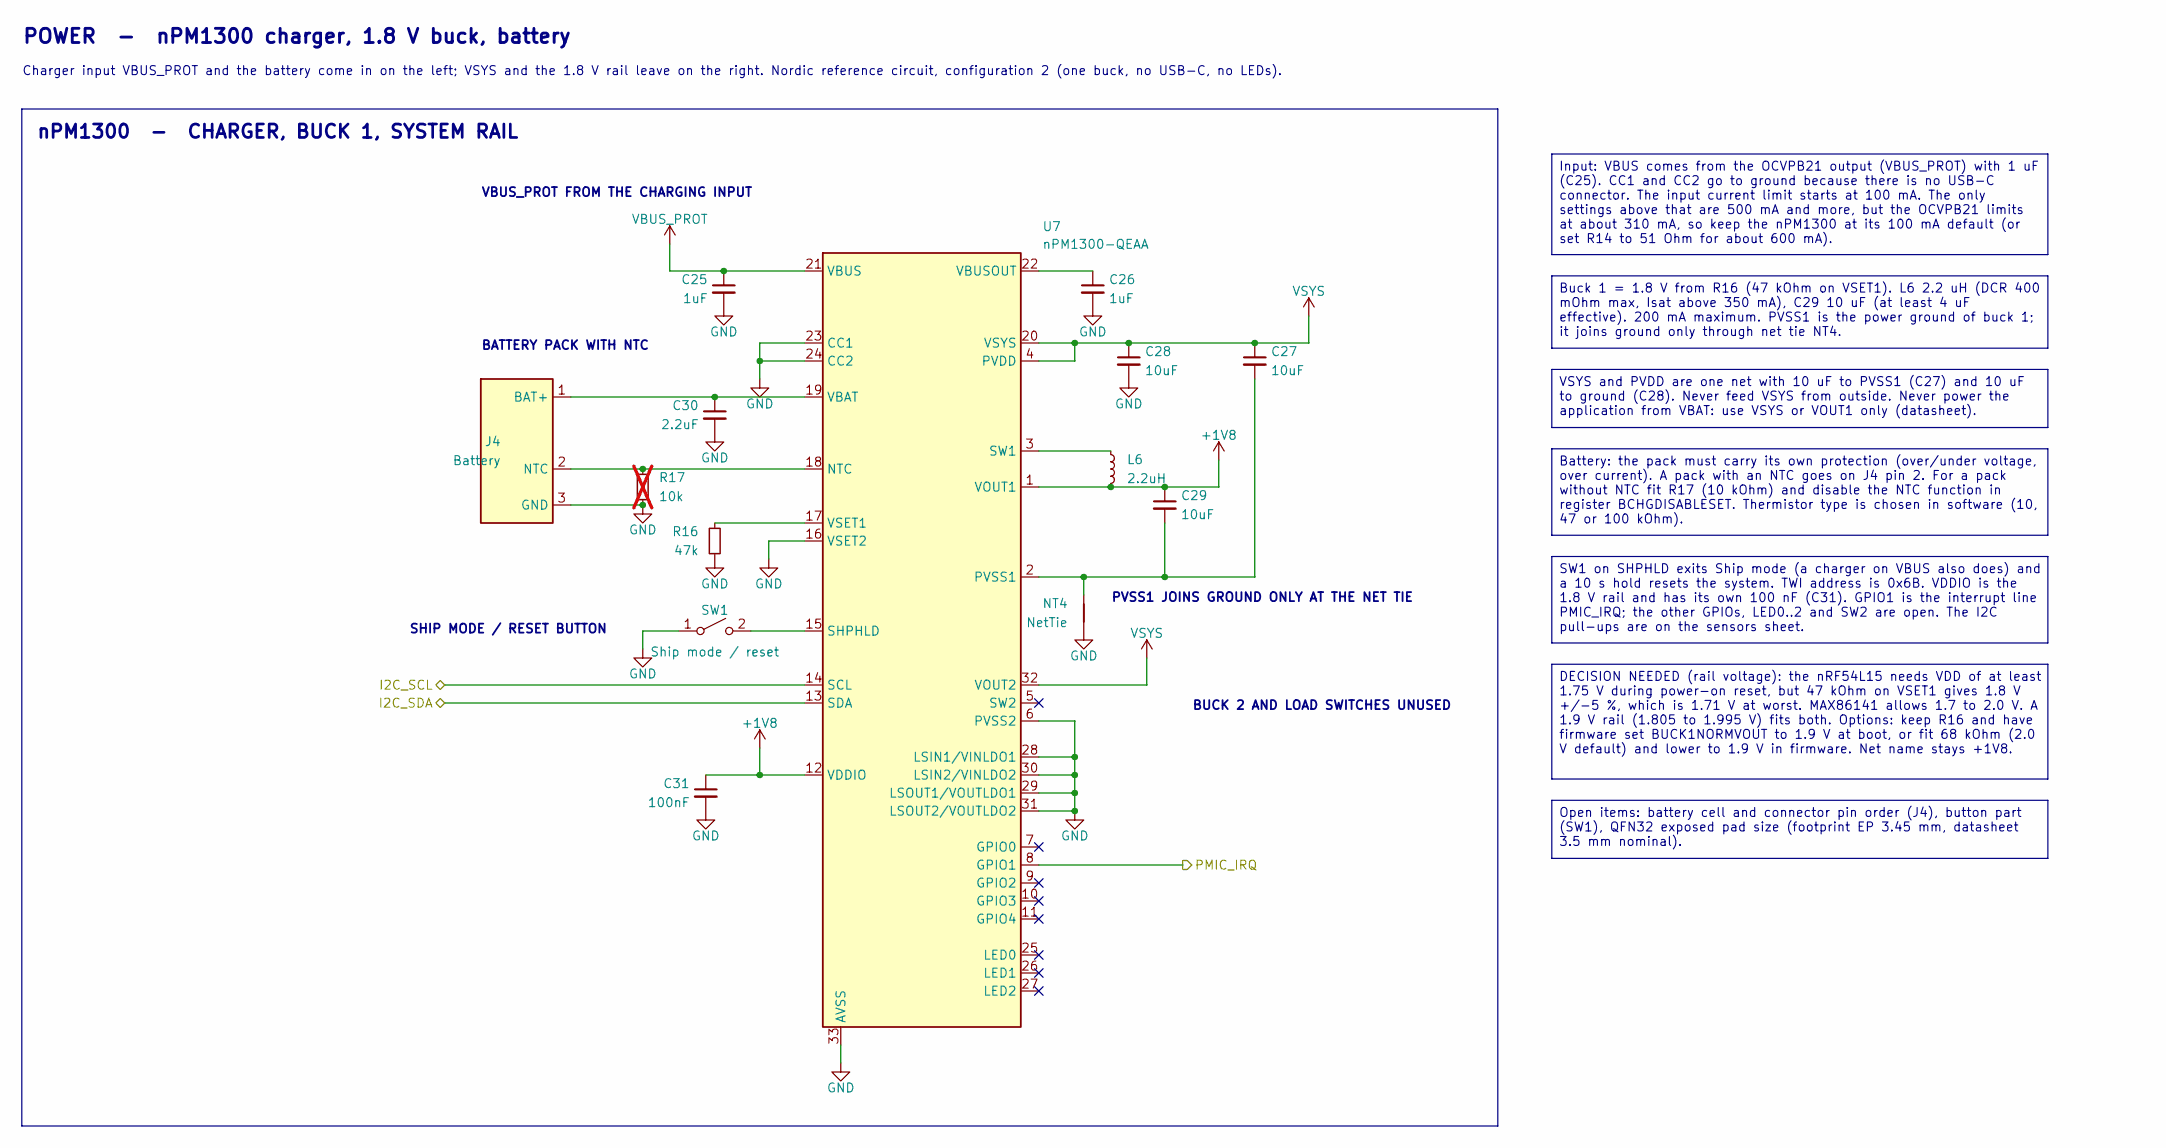
[picture p6: schematic power.kicad_sch]

Parts:
C25, C26: 1uF; C_0603_1608Metric
C27, C28, C29: 10uF; C_0603_1608Metric
C30: 2.2uF; C_0603_1608Metric
C31: 100nF; C_0201_0603Metric
J4: Battery; JST_SH_SM03B-SRSS-TB_1x03-1MP_P1.00mm_Horizontal
L6: 2.2uH; L_0805_2012Metric
NT4: NetTie; NetTie-2_SMD_Pad0.5mm
R16: 47k; R_0201_0603Metric
R17: 10k; R_0201_0603Metric; not fitted
SW1: Ship mode / reset; SW_SPST_B3U-1000P
U7: nPM1300-QEAA; QFN-32-1EP_5x5mm_P0.5mm_EP3.45x3.45mm

Connections:
+1V8: C29.1, C31.1, L6.2, U7.1 (VOUT1), U7.12 (VDDIO)
GND: C25.2, C26.2, C28.2, C30.2, C31.2, J4.3 (GND), NT4.1, R16.2, R17.2, SW1.1 (A), U7.6 (PVSS2), U7.16 (VSET2), U7.23 (CC1), U7.24 (CC2), U7.28 (LSIN1/VINLDO1), U7.29 (LSOUT1/VOUTLDO1), U7.30 (LSIN2/VINLDO2), U7.31 (LSOUT2/VOUTLDO2), U7.33 (AVSS)
I2C_SCL: U7.14 (SCL)
I2C_SDA: U7.13 (SDA)
unnamed: C26.1, U7.22 (VBUSOUT)
unnamed: C27.2, C29.2, NT4.2, U7.2 (PVSS1)
unnamed: C30.1, J4.1 (BAT+), U7.19 (VBAT)
unnamed: J4.2 (NTC), R17.1, U7.18 (NTC)
unnamed: L6.1, U7.3 (SW1)
unnamed: R16.1, U7.17 (VSET1)
unnamed: SW1.2 (B), U7.15 (SHPHLD)
PMIC_IRQ: U7.8 (GPIO1)
VBUS_PROT: C25.1, U7.21 (VBUS)
VSYS: C27.1, C28.1, U7.4 (PVDD), U7.20 (VSYS), U7.32 (VOUT2)

Notes on the sheet:
POWER - nPM1300 charger, 1.8 V buck, battery
Charger input VBUS_PROT and the battery come in on the left; VSYS and the 1.8 V rail leave on the right. Nordic reference circuit, configuration 2 (one buck, no USB-C, no LEDs).
nPM1300 - CHARGER, BUCK 1, SYSTEM RAIL
VBUS_PROT FROM THE CHARGING INPUT
BATTERY PACK WITH NTC
SHIP MODE / RESET BUTTON
PVSS1 JOINS GROUND ONLY AT THE NET TIE
BUCK 2 AND LOAD SWITCHES UNUSED
Input: VBUS comes from the OCVPB21 output (VBUS_PROT) with 1 uF (C25). CC1 and CC2 go to ground because there is no USB-C connector. The input current limit starts at 100 mA. The only settings above that are 500 mA and more, but the OCVPB21 limits at about 310 mA, so keep the nPM1300 at its 100 mA 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
Buck 1 = 1.8 V from R16 (47 kOhm on VSET1). L6 2.2 uH (DCR 400 mOhm max, Isat above 350 mA), C29 10 uF (at least 4 uF effective). 200 mA maximum. PVSS1 is the power ground of buck 1; it joins ground only through net tie NT4.
VSYS and PVDD are one net with 10 uF to PVSS1 (C27) and 10 uF to ground (C28). Never feed VSYS from outside. Never power the application from VBAT: use VSYS or VOUT1 only (datasheet).
Battery: the pack must carry its own protection (over/under voltage, over current). A pack with an NTC goes on J4 pin 2. For a pack without NTC fit R17 (10 kOhm) and disable the NTC function in register BCHGDISABLESET. Thermistor type is chosen in software (10, 47 or 100 kOhm).
SW1 on SHPHLD exits Ship mode (a charger on VBUS also does) and a 10 s hold resets the system. TWI address is 0x6B. VDDIO is the 1.8 V rail and has its own 100 nF (C31). GPIO1 is the interrupt line PMIC_IRQ; the other GPIOs, LED0..2 and SW2 are open. The I2C pull-ups are on the sensors sheet.
DECISION NEEDED (rail voltage): the nRF54L15 needs VDD of at least 1.75 V during power-on reset, but 47 kOhm on VSET1 gives 1.8 V +/-5 %, which is 1.71 V at worst. MAX86141 allows 1.7 to 2.0 V. A 1.9 V rail (1.805 to 1.995 V) fits both. Options: keep R16 and have firmware set BUCK1NORMVOUT to 1.9 V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
Open items: battery cell and connector pin order (J4), button part (SW1), QFN32 exposed pad size (footprint EP 3.45 mm, datasheet 3.5 mm nominal).
