HXRSHGIT/Smart-Watch-Rev-1.1/hardware/schematic/rf.kicad_sch

## KiCad design hardware/schematic/rf.kicad_sch (2026-11-05)

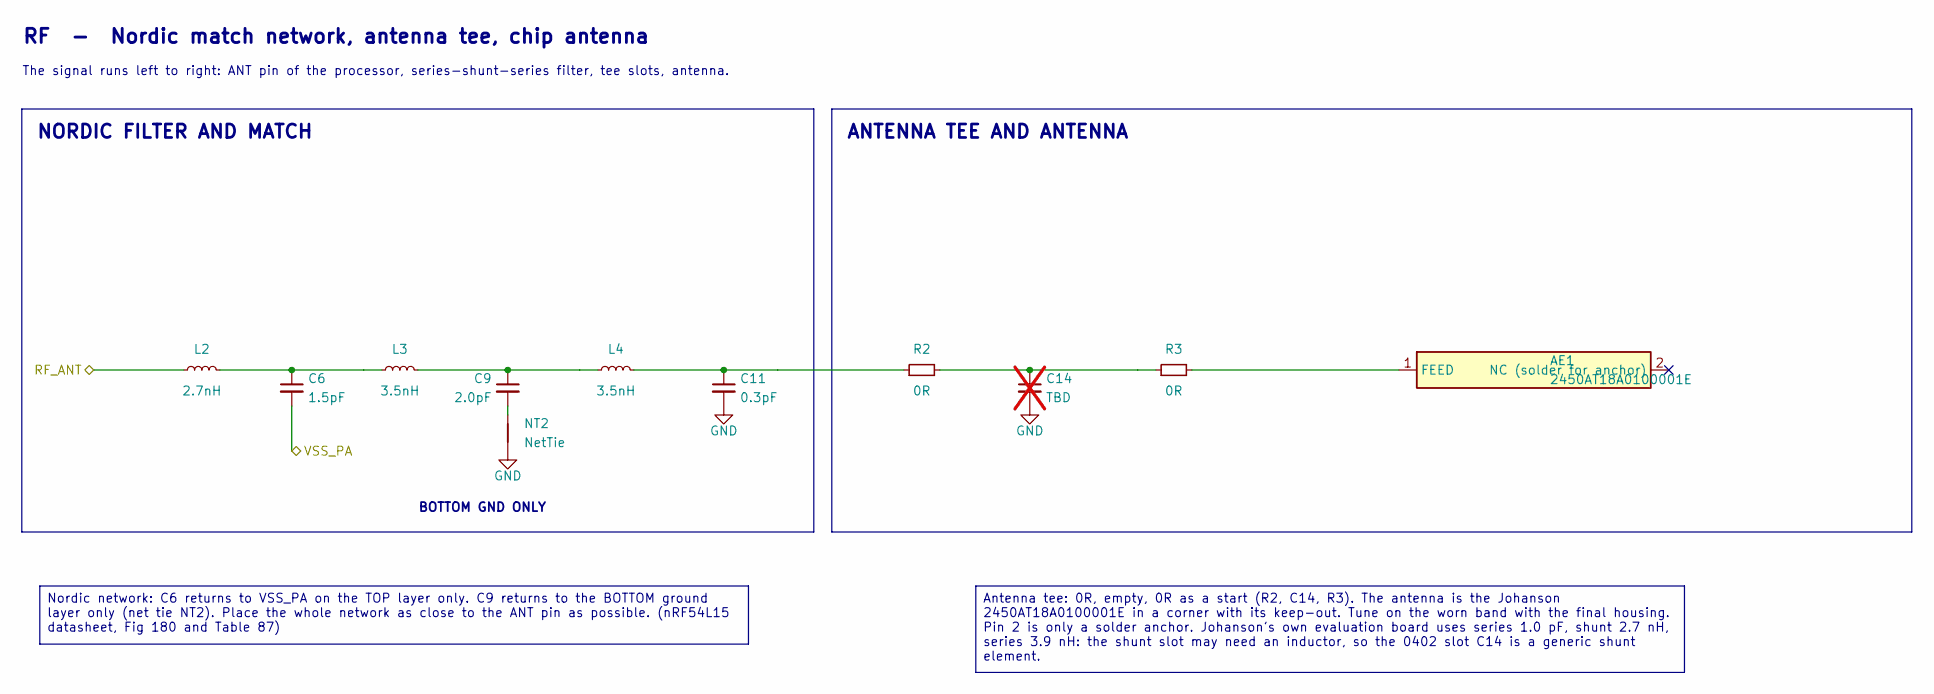
[picture p7: schematic rf.kicad_sch]

Parts:
AE1: 2450AT18A0100001E; Johanson_2450AT18A0100001E_1206
C6: 1.5pF; C_0201_0603Metric; MPN GJM0335C1E1R5WB01
C9: 2.0pF; C_0201_0603Metric; MPN GJM0335C1E2R0WB01
C11: 0.3pF; C_0201_0603Metric
C14: TBD; C_0402_1005Metric; not fitted
L2: 2.7nH; L_0201_0603Metric; MPN LQP03HQ2N7B02
L3, L4: 3.5nH; L_0201_0603Metric; MPN LQP03HQ3N5B02
NT2: NetTie; NetTie-2_SMD_Pad0.5mm
R2, R3: 0R; R_0402_1005Metric

Connections:
GND: C11.2, C14.2, NT2.1
unnamed: AE1.1 (FEED), R3.2
unnamed: C6.1, L2.2, L3.1
unnamed: C9.1, L3.2, L4.1
unnamed: C9.2, NT2.2
unnamed: C11.1, L4.2, R2.1
unnamed: C14.1, R2.2, R3.1
RF_ANT: L2.1
VSS_PA: C6.2

Notes on the sheet:
RF - Nordic match network, antenna tee, chip antenna
The signal runs left to right: ANT pin of the processor, series-shunt-series filter, tee slots, antenna.
NORDIC FILTER AND MATCH
ANTENNA TEE AND ANTENNA
BOTTOM GND ONLY
Nordic network: C6 returns to VSS_PA on the TOP layer only. C9 returns to the BOTTOM ground layer only (net tie NT2). Place the whole network as close to the ANT pin as possible. (nRF54L15 datasheet, Fig 180 and Table 87)
Antenna tee: 0R, empty, 0R as a start (R2, C14, R3). The antenna is the Johanson 2450AT18A0100001E in a corner with its keep-out. Tune on the worn band with the final housing. Pin 2 is only a solder anchor. Johanson's own evaluation board uses series 1.0 pF, shunt 2.7 nH, series 3.9 nH: the shunt s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
