HXRSHGIT/Smart-Watch-Rev-1.1/hardware/schematic/sensors.kicad_sch

## KiCad design hardware/schematic/sensors.kicad_sch (2026-11-05)

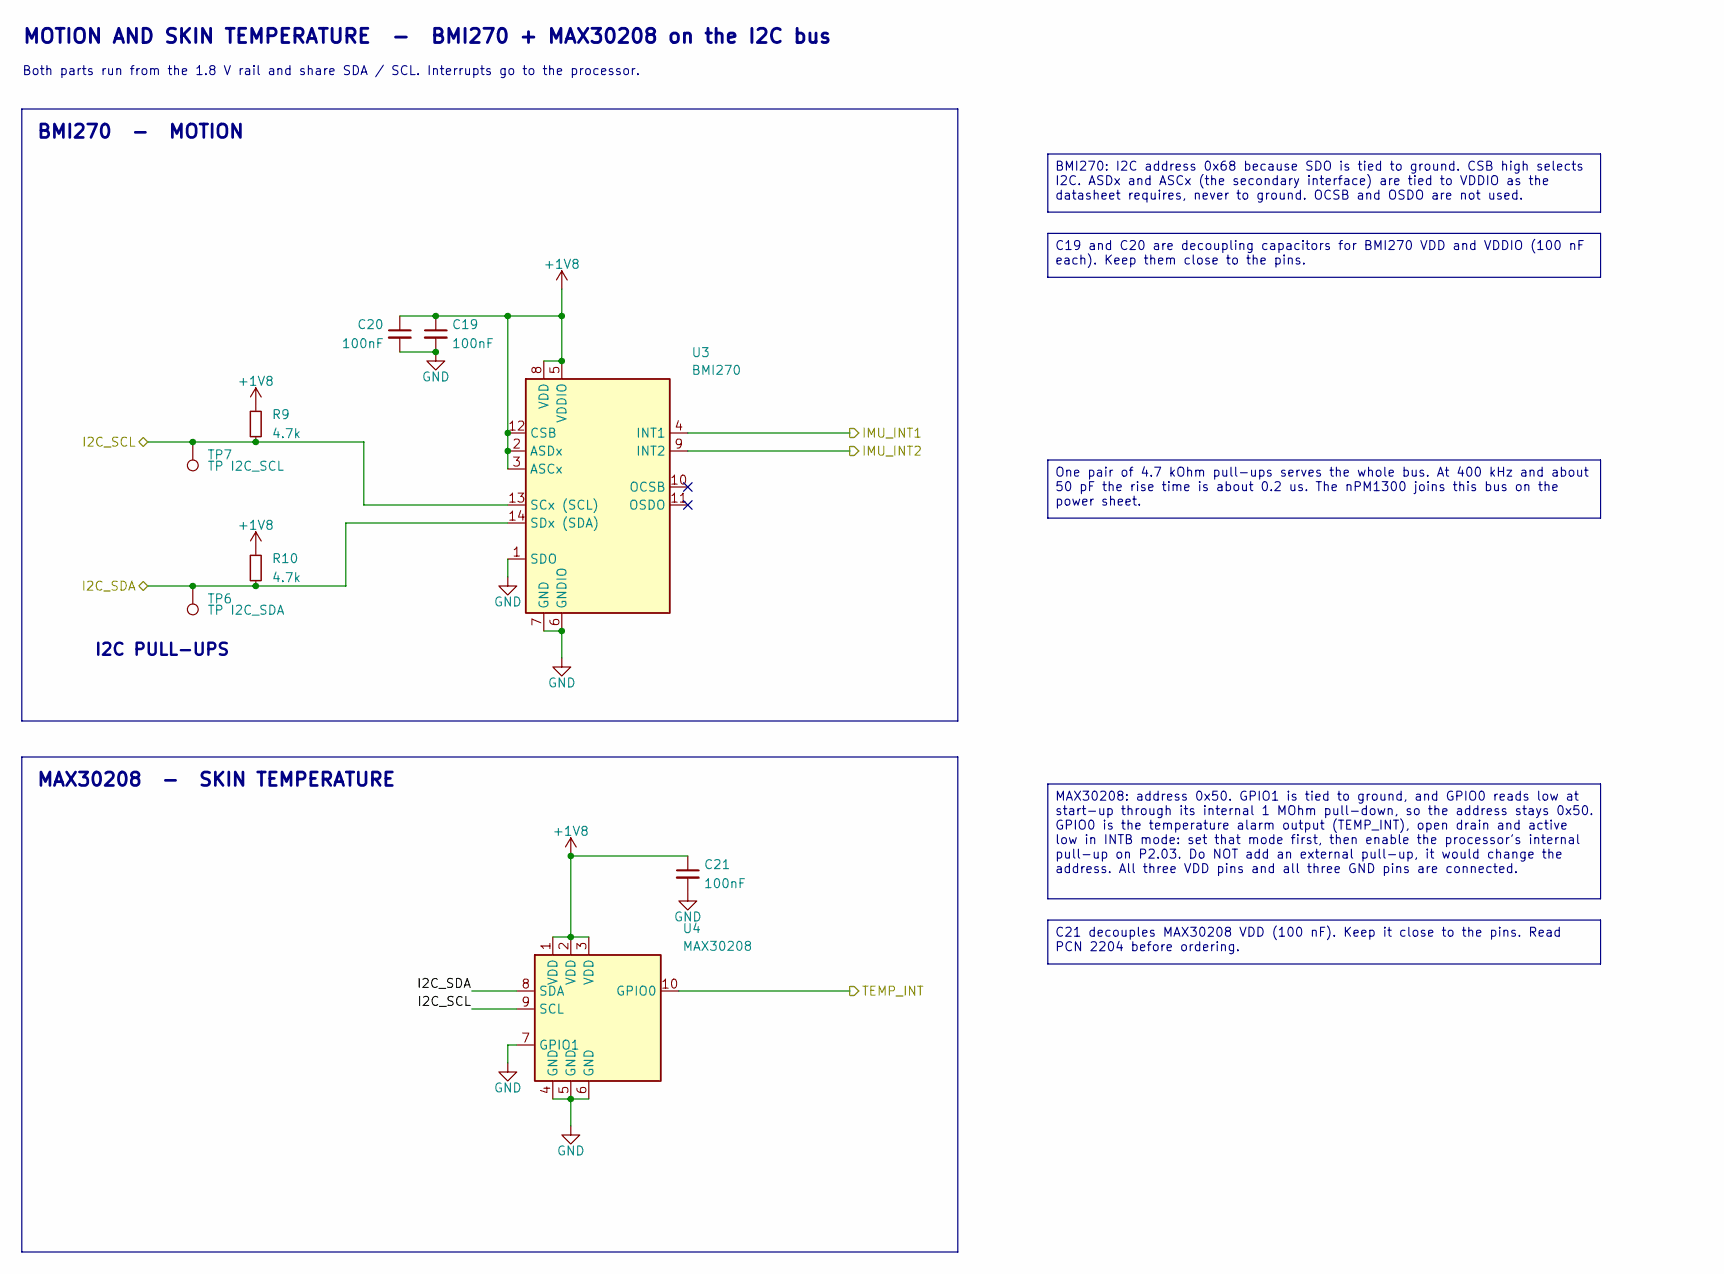
[picture p8: schematic sensors.kicad_sch]

Parts:
C19, C20, C21: 100nF; C_0201_0603Metric
R9, R10: 4.7k; R_0201_0603Metric
TP6: TP I2C_SDA; TestPoint_Pad_D1.0mm
TP7: TP I2C_SCL; TestPoint_Pad_D1.0mm
U3: BMI270; Bosch_LGA-14_3x2.5mm_P0.5mm
U4: MAX30208; MAX30208_TLGA-10_2x2mm

Connections:
+1V8: C19.1, C20.1, C21.1, R9.1, R10.1, U3.2 (ASDx), U3.3 (ASCx), U3.5 (VDDIO), U3.8 (VDD), U3.12 (CSB), U4.1 (VDD), U4.2 (VDD), U4.3 (VDD)
GND: C19.2, C20.2, C21.2, U3.1 (SDO), U3.6 (GNDIO), U3.7 (GND), U4.4 (GND), U4.5 (GND), U4.6 (GND), U4.7 (GPIO1)
I2C_SCL: R9.2, TP7.1, U3.13 (SCx (SCL)), U4.9 (SCL)
I2C_SDA: R10.2, TP6.1, U3.14 (SDx (SDA)), U4.8 (SDA)
IMU_INT1: U3.4 (INT1)
IMU_INT2: U3.9 (INT2)
TEMP_INT: U4.10 (GPIO0)

Notes on the sheet:
MOTION AND SKIN TEMPERATURE - BMI270 + MAX30208 on the I2C bus
Both parts run from the 1.8 V rail and share SDA / SCL. Interrupts go to the processor.
BMI270 - MOTION
I2C PULL-UPS
MAX30208 - SKIN TEMPERATURE
BMI270: I2C address 0x68 because SDO is tied to ground. CSB high selects I2C. ASDx and ASCx (the secondary interface) are tied to VDDIO as the datasheet requires, never to ground. OCSB and OSDO are not used.
C19 and C20 are decoupling capacitors for BMI270 VDD and VDDIO (100 nF each). Keep them close to the pins.
MAX30208: address 0x50. GPIO1 is tied to ground, and GPIO0 reads low at start-up through its internal 1 MOhm pull-down, so the address stays 0x50. GPIO0 is the temperature alarm output (TEMP_INT), open drain and active low in INTB mode: set that mode first, then enable the processor's internal pull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
C21 decouples MAX30208 VDD (100 nF). Keep it close to the pins. Read PCN 2204 before ordering.
One pair of 4.7 kOhm pull-ups serves the whole bus. At 400 kHz and about 50 pF the rise time is about 0.2 us. The nPM1300 joins this bus on the power sheet.
