HXRSHGIT/Smart-Watch-Rev-1.1/hardware/schematic/test.kicad_sch

## KiCad design hardware/schematic/test.kicad_sch (2026-11-05)

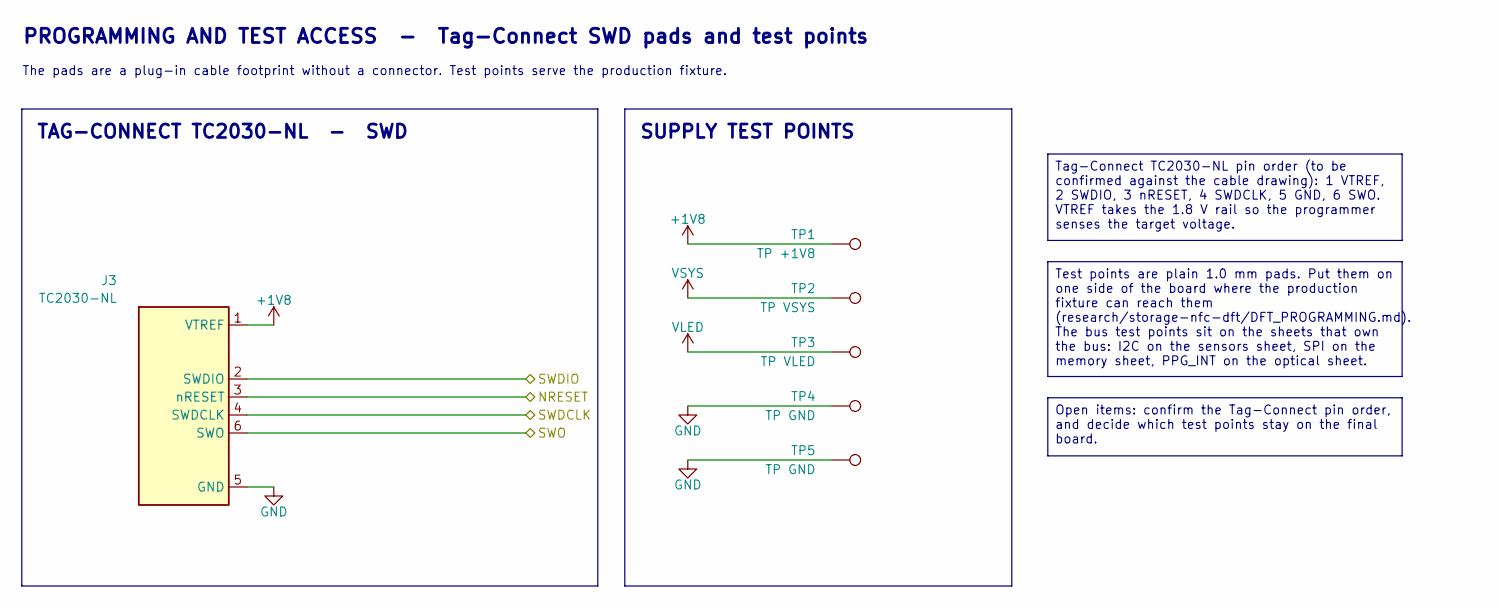
[picture p9: schematic test.kicad_sch]

Parts:
J3: TC2030-NL; Tag-Connect_TC2030-IDC-NL_2x03_P1.27mm_Vertical
TP1: TP +1V8; TestPoint_Pad_D1.0mm
TP2: TP VSYS; TestPoint_Pad_D1.0mm
TP3: TP VLED; TestPoint_Pad_D1.0mm
TP4, TP5: TP GND; TestPoint_Pad_D1.0mm

Connections:
+1V8: J3.1 (VTREF), TP1.1
GND: J3.5 (GND), TP4.1, TP5.1
NRESET: J3.3 (nRESET)
SWDCLK: J3.4 (SWDCLK)
SWDIO: J3.2 (SWDIO)
SWO: J3.6 (SWO)
VLED: TP3.1
VSYS: TP2.1

Notes on the sheet:
PROGRAMMING AND TEST ACCESS - Tag-Connect SWD pads and test points
The pads are a plug-in cable footprint without a connector. Test points serve the production fixture.
TAG-CONNECT TC2030-NL - SWD
SUPPLY TEST POINTS
Tag-Connect TC2030-NL pin order (to be confirmed against the cable drawing): 1 VTREF, 2 SWDIO, 3 nRESET, 4 SWDCLK, 5 GND, 6 SWO. VTREF takes the 1.8 V rail so the programmer senses the target voltage.
Test points are plain 1.0 mm pads. Put them on one side of the board where the production fixture can reach them (research/storage-nfc-dft/DFT_PROGRAMMING.md). The bus test points sit on the sheets that own the bus: I2C on the sensors sheet, SPI on the memory sheet, PPG_INT on the optical sheet.
Open items: confirm the Tag-Connect pin order, and decide which test points stay on the final board.
