HXRSHGIT/Smart-Watch-Rev-1.1/(commit log)

2026-10-14 MCU/BLE: nRF54L15 trade study, pairing and DFU security, antenna plan
2026-10-14 Power: duty-cycle battery model, power tree, peak load, pogo charging
2026-10-14 Display/haptics: real 0.49in panel, back-power topology, dead-front maths, LRA and wake
2026-10-14 Sensors: BMI270 modes and power, floors and vent, skin-temp thermal path, time sync
2026-10-18 Define approved USB-powered sensor prototype for Iteration 1
2026-10-20 Add component selection and Iteration 1 schematic plan; fix MAX30208 address pins
2026-10-22 Add ESP32-C3 vs nRF54L15 comparisons and SoC battery model; use MINI-1-N4X (N4 is NRND)
2026-10-28 Add hardware: tool decision, reference review, datasheet requirements and KiCad 9 schematic (8 sheets, checked)
    KiCad project in hardware/schematic with generator and independent checker. Power (nPM1300) and memory (MX25R3235F) sheets wait for their datasheets. Datasheet PDFs and vendor reference files are not committed.
2026-11-05 Redraw schematic in wired hand-drawn style; add power and memory sheets; datasheet review
    All ten pages: root, charging input, power (nPM1300), LED supply, processor, flash memory, RF, optical, sensors, test. Wires instead of labels (12 labels left), frames and notes, ERC clean, connectivity check against an independent expected table (299 pins, 63 nets), no wire crossings. REVIEW.md records the datasheet review and four open decisions. Datasheets and vendor reference files are not committed.
2026-11-05 Fix CSP pitch in MCU trade study (0.3 mm per datasheet v1.0)
2026-11-07 Add make_board.py: build the PCB from KiCad's own netlist
    Creates the .kicad_pcb from the schematic with footprints, nets and symbol links
    exactly as kicad-cli exports them (91 footprints, 94 nets). Parts are laid out
    in a loose grid so none overlap. kicad-cli pcb drc --schematic-parity reports 0
    issues. Output goes to hardware/schematic/build (git-ignored).
